ustajan/GeigerTINY/Bill_of_Materials.xlsx

component description | count | price for the package | source | units in the package | notes | price/unit
HV module
3 AAA battery holder with switch | 1 | 12 | https://www.amazon.com/gp/product/B081C7FYY4/ref=ppx_yo_dt_b_asin_title_o01_s00?ie=UTF8&psc=1 | 10 |  | 1.20
4.7 nF | 1 | 22.67 | https://www.digikey.com/en/products/detail/vishay-beyschlag-draloric-bc-components/S472M39Z5UN63L6R/2832771 | 100 | HV | 0.23
47 mH, DC R<200 ohms | 1 | 3.27 | https://www.digikey.com/en/products/detail/bourns-inc/RLB0812-473KL/2561328 | 10 | inductor | 0.33
1 GOhm | 1 | 54.04 | https://www.digikey.com/en/products/detail/te-connectivity-passive-product/RGP0207CHK1G0/2389890 | 100 |  | 0.54
1 or 1.1 MOhm | 1 | 2.87 | https://www.digikey.com/en/products/detail/yageo/CFR-12JB-52-1M1/3927 | 100 |  | 0.03
Geiger-Muller SBM-20 tube | 1 | 117 | https://www.ebay.com/itm/196021255795?hash=item2da3c6fe73:g:3zwAAOSwsQ1i0Jes | 10 | these are not always available, need to search around ebay. atlanta_deals however is by far the best vendor. | 11.70
BA159 | 1 | 23.58 | https://www.digikey.com/en/products/detail/vishay-general-semiconductor-diodes-division/UF4007-E3-73/2142323 | 100 | diode | 0.24
fuse clips (for SBM-20 mounting) | 2 | 31.38 | https://www.digikey.com/en/products/detail/keystone-electronics/3500/9921798 | 100 |  | 0.63
AAA batteries | 3 |  | buy a big pack on amazon
breadboard 170 point | 1 | 13.95 | https://www.amazon.com/Cenrykay-12Packs-solderless-breadboard-Arduino/dp/B07KG8VW21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 | 12 |  | 1.16
FQN1N50C, HV n-chann MOSFET | 1 | 5.21 | https://www.digikey.com/en/products/detail/onsemi/FQN1N50CTA/1923037 | 10 | obsolete…just get a HV n-channel MOSFET, for example try (untested) this: https://www.digikey.com/en/products/detail/stmicroelectronics/STQ2LN60K3-AP/3711344 | 0.52
DAQ module
attiny85 | 1 | 1.66 | https://www.digikey.com/en/products/detail/microchip-technology/ATTINY85-20PU/735469 | 1 |  | 1.66
128x64 OLED | 1 | 14.88 | https://www.amazon.com/Hosyond-Display-Self-Luminous-Compatible-Raspberry/dp/B09C5K91H7?s=electronics | 5 |  | 2.98
100 kOhm | 4 | 2.6 | https://www.digikey.com/en/products/detail/yageo/CFR-25JB-52-100K/245 | 100 |  | 0.10
47 pF | 1 | 17.06 | https://www.digikey.com/en/products/detail/kemet/C317C470K2G5TA7301/6562418 | 100 |  | 0.17
22 nF | 1 | 1.51 | https://www.digikey.com/en/products/detail/vishay-beyschlag-draloric-bc-components/K223K15X7RF5TL2/286534 | 10 |  | 0.15
General
wiring: black | 1 |  | OPTIONAL |  | ground
wiring: white | 1 |  |  |  | 5 V
wiring: red | 1 |  |  |  | HV
wiring: blue | 1 |  |  |  | signal / internal
jumper wire | 1 | 13.3 | https://www.amazon.com/gp/product/B088WNZXFQ/ref=ppx_yo_dt_b_search_asin_title?ie=UTF8&psc=1 | 5 |  | 2.66
Enclosure (two options) | 1 | 21.8 | https://www.amazon.com/gp/product/B09XX3J6DM/ref=ppx_yo_dt_b_asin_title_o06_s01?ie=UTF8&th=1 | 12 |  | 1.82
 | 1 | 28 |  | 6
Total / package |  | 386.78
Total / unit |  | 26.11
