ustajan/GeigerTINY/(commit log)

2024-02-07 Added BOM
    [Bill_of_Materials.xlsx]
2026-01-09 Updated the schematic to include the 33uF cap, and made it a little easier to read and assemble.
